Dylanfg123/Signalyzer/README.md

View this project on [CADLAB.io](https://cadlab.io/project/26944). 

# Signalyzer
