Dylanfg123/Signalyzer/Docs/Produce_DanZhi.SMT_Snapshot.Top.2391258A_Y2.SMT02211131024478.png

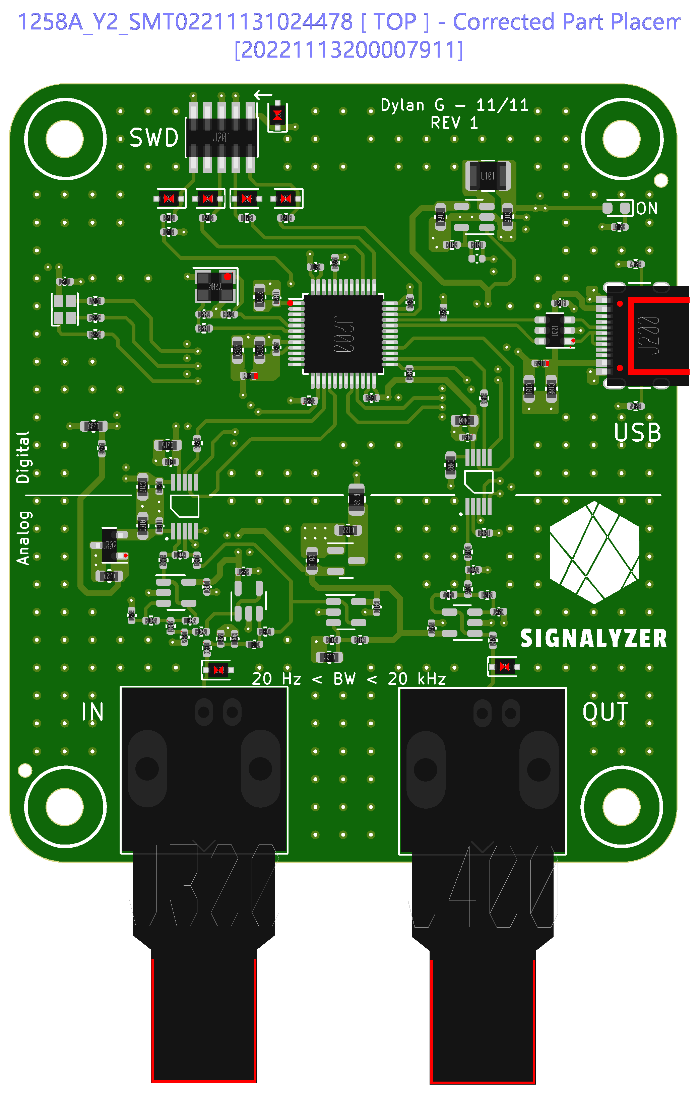
Docs/Produce_DanZhi.SMT_Snapshot.Top.2391258A_Y2.SMT02211131024478.png
