Dylanfg123/Signalyzer/Docs/RoughBom.xlsx

 | Main
 | Part | Description | Qty | Price |  | Link | Alt Link
MCU | STM32F103CBT6 | ARM MCU, Motor Control, STM32 Family STM32F1 Series Microcontrollers, ARM Cortex-M3, 32 bit, 72 MHz | 1 | 8.78 | 11.07 | https://www.newark.com/stmicroelectronics/stm32f103cbt6/microcontroller-mcu-32-bit-cortex/dp/11N8296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 | https://www.arrow.com/en/products/stm32f103cbt6/stmicroelectronics
ADC | ADC141S626CIMM/NOPB | 14 Bit Analog to Digital Converter 1 Input 1 SAR 10-VSSOP | 1 | 11.71 |  | https://www.digikey.com/en/products/detail/ADC141S626CIMM-NOPB/ADC141S626CIMM-NOPBCT-ND/1836097?curr=usd
DAC | DAC7563TDGST | IC DAC 12BIT V-OUT 10VSSOP | 1 | 7.33 |  | https://www.digikey.com/en/products/detail/texas-instruments/DAC7563SDGST/2749385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
SW REG | TLV62569DBVR | Conv DC-DC 2.5V to 5.5V Synchronous Step Down Single-Out 0.6V to 5.5V 2A 5-Pin SOT-23 T/R | 1 | 0.89 |  | https://www.arrow.com/en/products/tlv62569dbvr/texas-instruments?region=nac
LDO | MCP1792T-3302H/CB | IC REG LIN 3.3V 100MA SOT23A-3 | 1 | 0.8 |  | https://www.digikey.com/en/products/detail/microchip-technology/MCP1792T-3302H-CB/10297921
OPAMP | MCP6001UT-I/OT | IC OPAMP GP 1 CIRCUIT SOT23-5 |  | 0.32 |  | https://www.digikey.com/en/products/detail/microchip-technology/MCP6001UT-I-OT/562450
ESD USB | USBLC6-2SC6Y | TVS DIODE 5.25VWM 17VC SOT23-6 | 1 | 1.07 |  | https://www.digikey.com/en/products/detail/stmicroelectronics/USBLC6-2SC6Y/2756523
TVS | PESD3V3L1BA,115 | TVS DIODE 3.3VWM 26VC SOD323 | 7 | 0.5 |  | https://www.digikey.com/en/products/detail/nexperia-usa-inc/PESD3V3L1BA-115/1157438
 | Passives/Connectors
USB C | TYPE-C-31-M-12 | 5A 1 16 Female Type-C SMD USB Connectors ROHS | 1 | 1.13 |  | https://www.lcsc.com/product-detail/USB-Type-C_Korean-Hroparts-Elec-TYPE-C-31-M-12_C165948.html
RGB LED | E6C1206RGBC3UDA | RGB 1206 Light Emitting Diodes (LED) ROHS | 1 | 0.62 |  | https://www.lcsc.com/product-detail/Light-Emitting-Diodes-LED_EKINGLUX-E6C1206RGBC3UDA_C375571.html
VREF | ref3033aidbzt | 3.3-V, 50-ppm/°C, 50-µA in 3-pin SOT-23 package series (bandgap) voltage reference | 1
BNC | 031-5640-1010 | Conn BNC 0Hz to 1GHz 50Ohm Solder RA Thru-Hole RCP Gold | 2 | 2.53 |  | https://www.newark.com/amphenol-rf/031-5640-1010/rf-coaxial-bnc-bulkhead-jack-r/dp/93F7525?CMP=AFC-OP
crystal
 |  |  |  | 35.68 | 31.8
 |  |  |  | Spent so far: | $123.73
