Dylanfg123/Signalyzer/HRO_TYPE-C-31-M-12.step

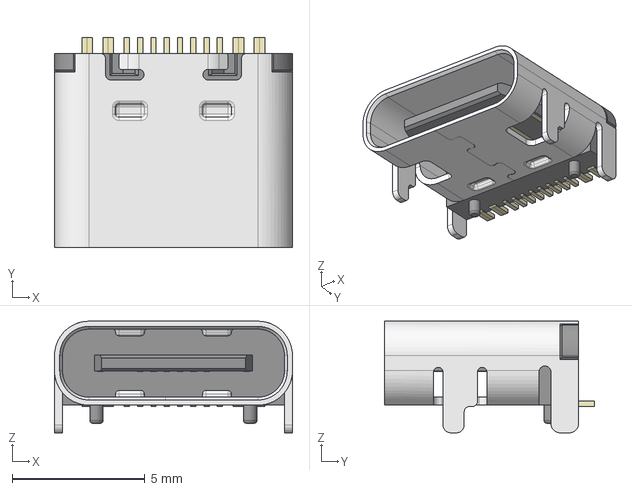
[picture p2: CAD file, 2023-05-13]
HRO_TYPE-C-31-M-12.step
8.95 x 7.90 x 4.20 mm
