Dylanfg123/Signalyzer/DGS0010A.STEP

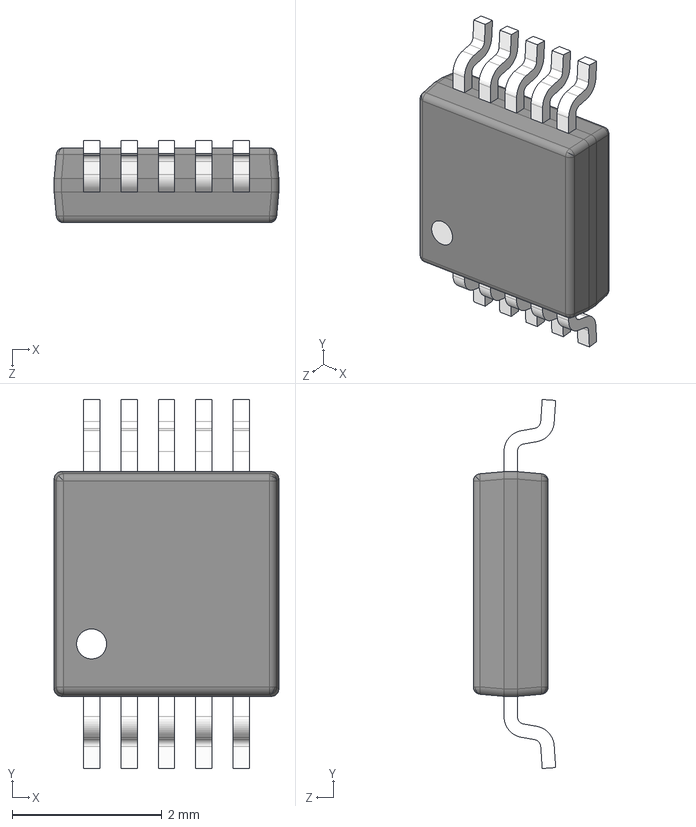
[picture p3: CAD file, 2023-05-13]
DGS0010A.STEP
3.00 x 4.93 x 1.10 mm
DGS0010A_ASM_LEAD-SO#LEAD-SO;LEAD-SO
DGS0010A_ASM_LEAD-SO#LEAD-SO;LEAD-SO_2
DGS0010A_ASM_LEAD-SO#LEAD-SO;LEAD-SO_3
DGS0010A_ASM_LEAD-SO#LEAD-SO;LEAD-SO_4
DGS0010A_ASM_LEAD-SO#LEAD-SO;LEAD-SO_5
DGS0010A_ASM_LEAD-SO#LEAD-SO;LEAD-SO_6
DGS0010A_ASM_LEAD-SO#LEAD-SO;LEAD-SO_7
DGS0010A_ASM_LEAD-SO#LEAD-SO;LEAD-SO_8
DGS0010A_ASM_LEAD-SO#LEAD-SO;LEAD-SO_9
DGS0010A_ASM_LEAD-SO#LEAD-SO;LEAD-SO_10
DGS0010A_ASM_BODY-SO#BODY-SO;BODY-SO
