Dylanfg123/Signalyzer/BNC_B6252HB-NPP3G-50.stp

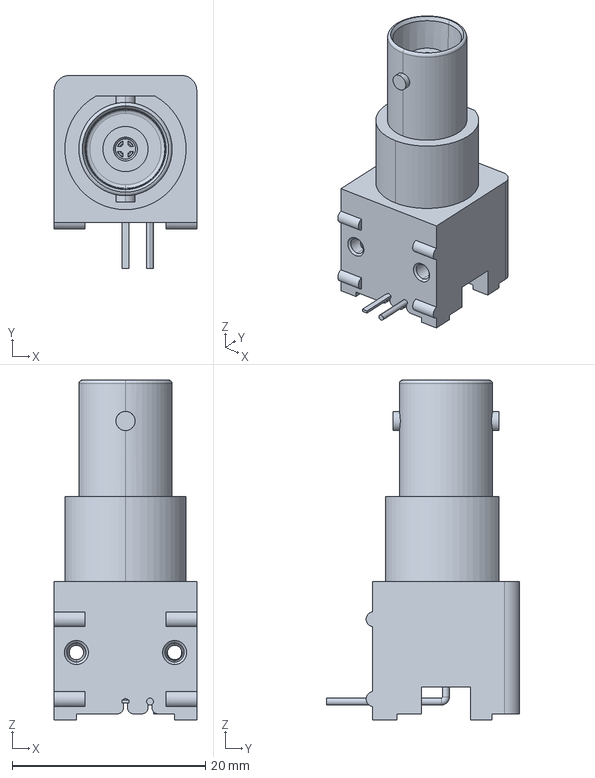
[picture p4: CAD file, 2023-05-13]
BNC_B6252HB-NPP3G-50.stp
14.8 x 20.0 x 35.2 mm
