Dylanfg123/Signalyzer/Signalyzer.kicad_pcb

## KiCad design Signalyzer.kicad_pcb (2023-05-13)

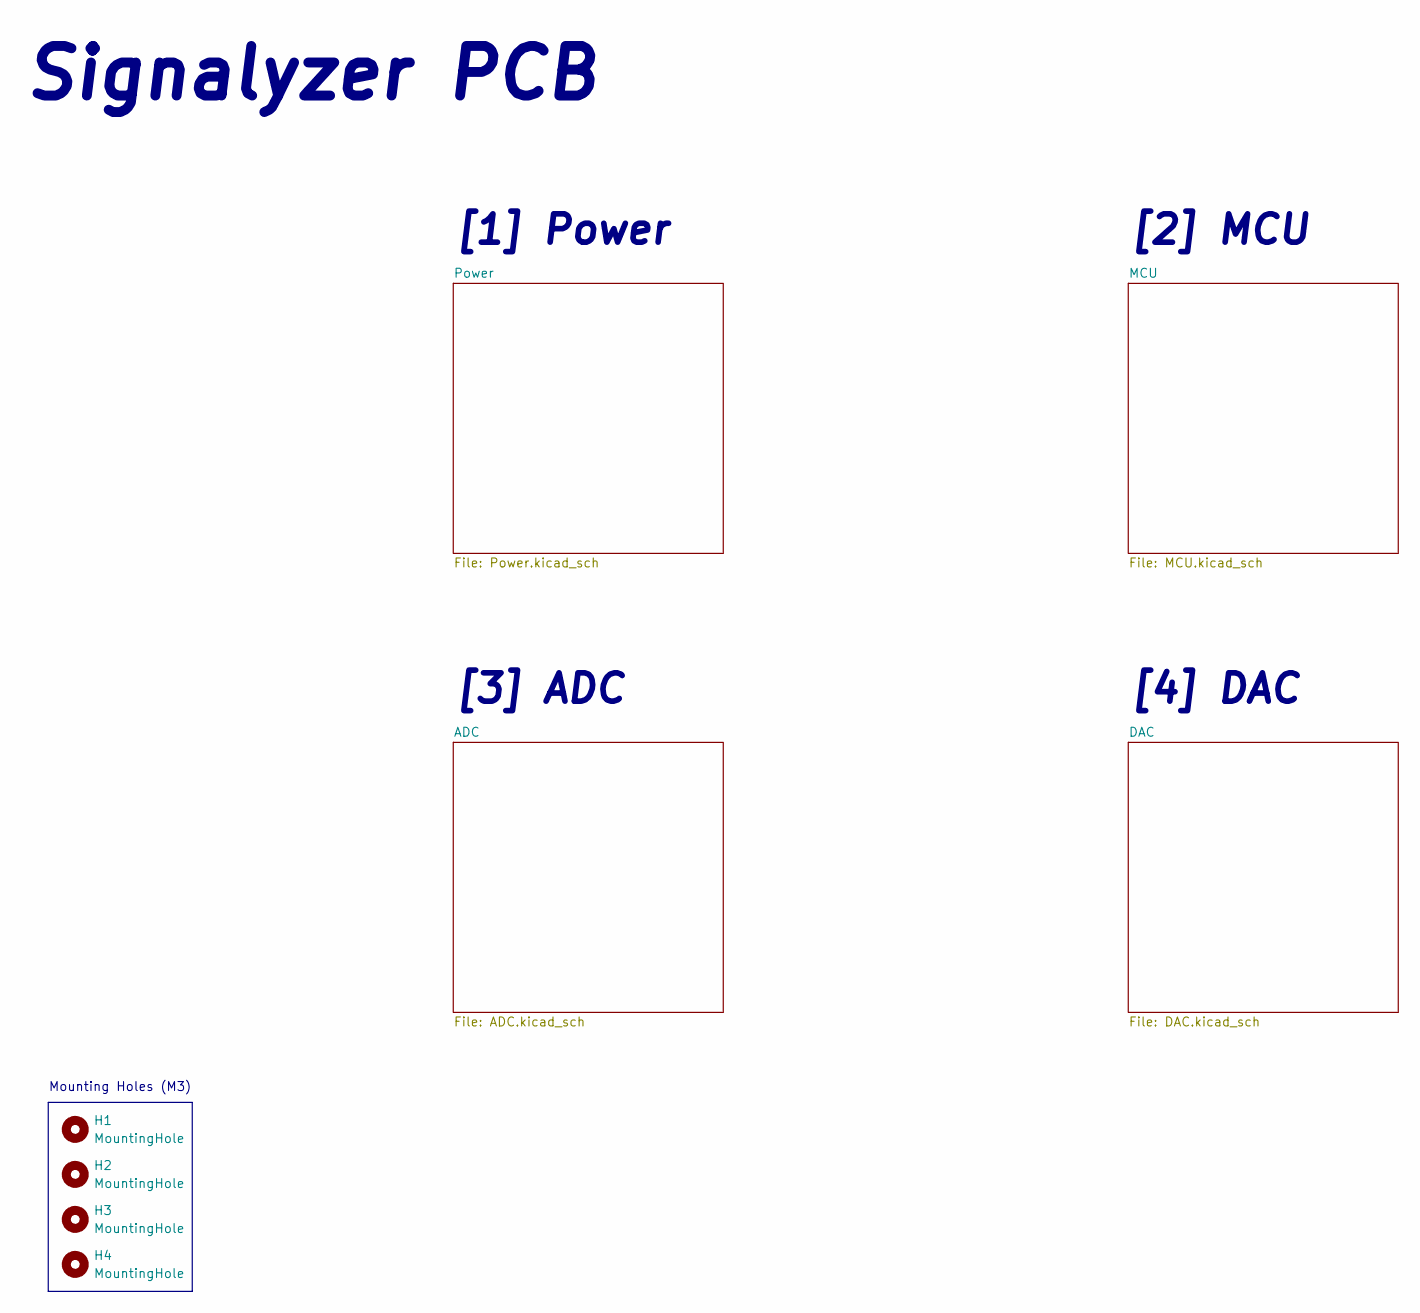
[picture p5: schematic Signalyzer.kicad_sch]

Parts:
H1, H2, H3, H4: MountingHole; MountingHole_3.2mm_M3

Notes on the sheet:
[2] MCU
Mounting Holes (M3)
[4] DAC
Signalyzer PCB
[3] ADC
[1] Power

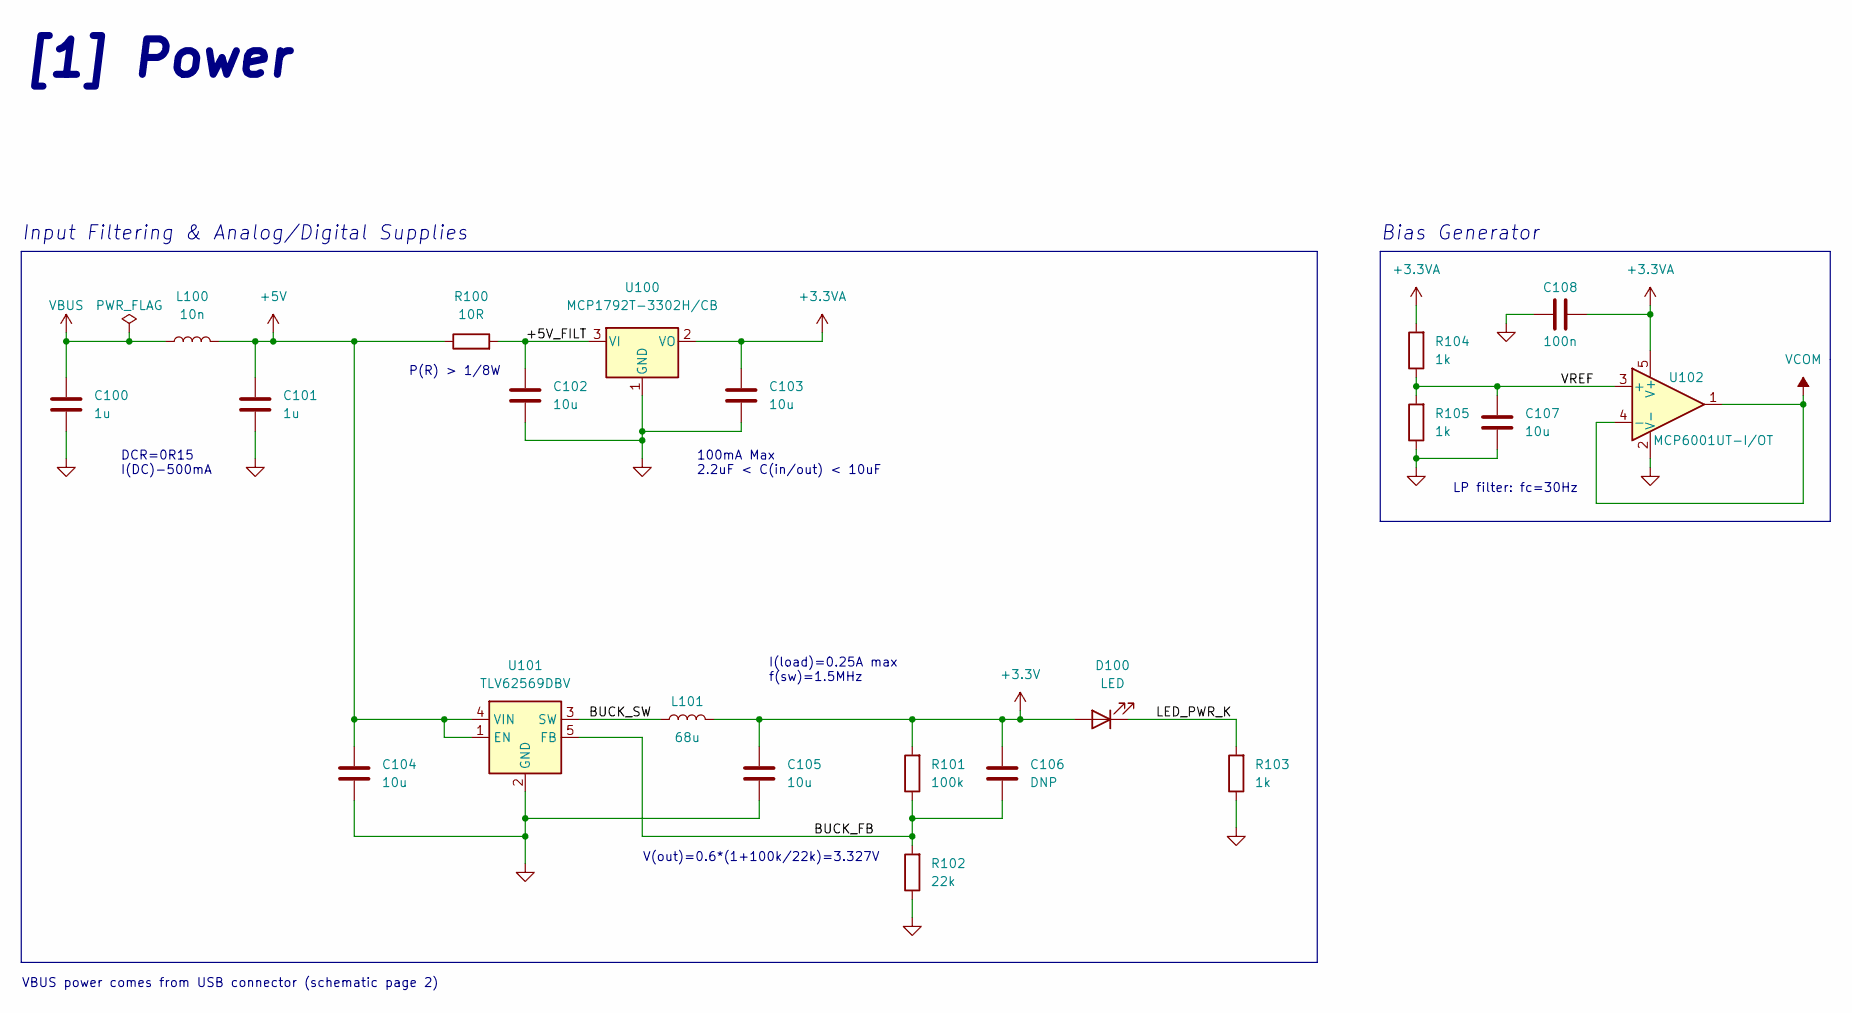
[picture p6: schematic Power.kicad_sch, Signalyzer]

Parts:
C100, C101: 1u; C_0603_1608Metric; Manufacturer Part Number CL10B105KA8VPJC; LCSC Part # C472462
C102, C103, C104, C105, C107: 10u; C_0603_1608Metric; Manufacturer Part Number GRM188R61C106KAALD; LCSC Part # C86275
C106: DNP; C_0402_1005Metric
C108: 100n; C_0402_1005Metric; Manufacturer Part Number CGA2B3X7R1V104KT0Y0F; LCSC Part # C343047
D100: LED; LED_0603_1608Metric; Manufacturer Part Number TJ-S1608SW6TDSLC2R2G-A5; LCSC Part # C601671
L100: 10n; L_0402_1005Metric; Manufacturer Part Number MHQ1005P10NJT000; LCSC Part # C445746
L101: 68u; L_1210_3225Metric; Manufacturer Part Number BCL322520RT-680M-D; LCSC Part # C3221319
R100: 10R; R_0805_2012Metric; Manufacturer Part Number RTAN0805BKE10R0; LCSC Part # C346749
R101: 100k; R_0402_1005Metric; Manufacturer Part Number ERA2AEB104X; LCSC Part # C445619
R102: 22k; R_0402_1005Metric; Manufacturer Part Number PTFR0402B22K0N9; LCSC Part # C2693021
R103, R104, R105: 1k; R_0402_1005Metric; Manufacturer Part Number ERA2AEB102X; LCSC Part # C445596
U100: MCP1792T-3302H/CB; SOT-23; Manufacturer Part Number MCP1792T-3302H/CB
U101: TLV62569DBV; SOT-23-5; Manufacturer Part Number TLV62569DBVR
U102: MCP6001UT-I/OT; SOT-23-5; Manufacturer Part Number MCP6001UT-I/OT

Connections:
+3.3VA: C103.1, C108.2, R104.2, U100.2 (VO), U102.5 (V+); also elsewhere on the board
+3V3: C105.1, C106.1, D100.2 (A), L101.2, R101.2; also elsewhere on the board
+5V: C101.1, C104.1, L100.2, R100.1, U101.1 (EN), U101.4 (VIN); also elsewhere on the board
/Power/+5V_FILT: C102.1, R100.2, U100.3 (VI)
/Power/BUCK_FB: C106.2, R101.1, R102.2, U101.5 (FB)
/Power/BUCK_SW: L101.1, U101.3 (SW)
/Power/LED_PWR_K: D100.1 (K), R103.2
/Power/VREF: C107.1, R104.1, R105.2, U102.3 (+)
GND: C100.2, C101.2, C102.2, C103.2, C104.2, C105.2, C107.2, C108.1, R102.1, R103.1, R105.1, U100.1 (GND), U101.2 (GND), U102.2 (V-); also elsewhere on the board
VBUS: C100.1, L100.1; also elsewhere on the board
VCOM: U102.1, U102.4 (-); also elsewhere on the board

Notes on the sheet:
100mA Max 2.2uF < C(in/out) < 10uF
VBUS power comes from USB connector (schematic page 2)
P(R) > 1/8W
V(out)=0.6*(1+100k/22k)=3.327V
LP filter: fc=30Hz
I(load)=0.25A max f(sw)=1.5MHz
DCR=0R15 I(DC)-500mA
Input Filtering & Analog/Digital Supplies
Bias Generator
[1] Power

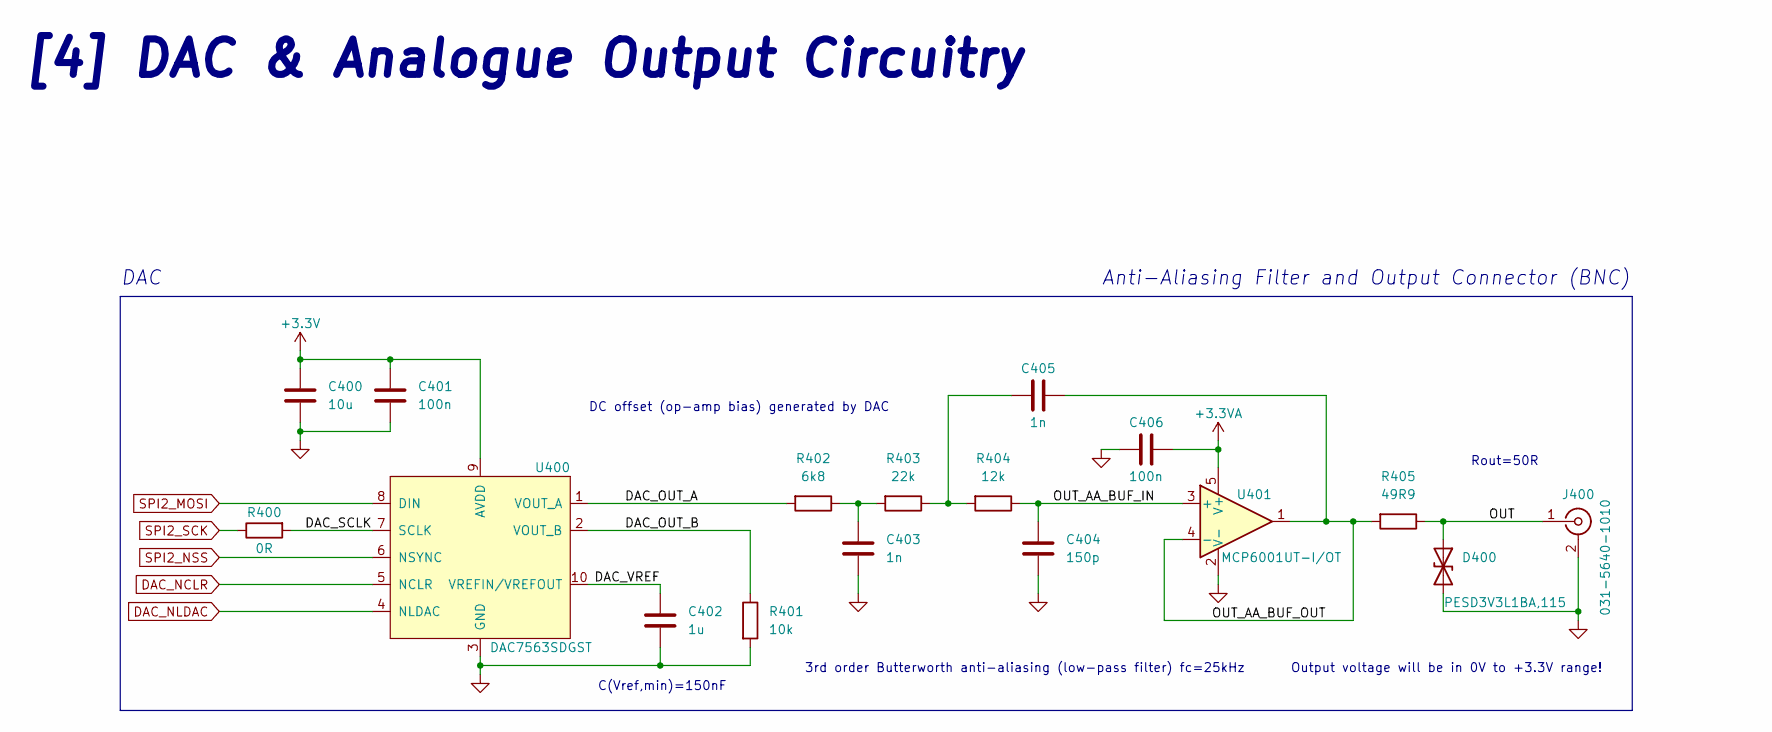
[picture p7: schematic DAC.kicad_sch, Signalyzer]

Parts:
C400: 10u; C_0603_1608Metric; Manufacturer Part Number GRM188R61C106KAALD; LCSC Part # C86275
C401, C406: 100n; C_0402_1005Metric; Manufacturer Part Number CGA2B3X7R1V104KT0Y0F; LCSC Part # C343047
C402: 1u; C_0603_1608Metric; Manufacturer Part Number CL10B105KA8VPJC; LCSC Part # C472462
C403, C405: 1n; C_0402_1005Metric; Manufacturer Part Number GRM1555C2A102GE01D; LCSC Part # C3010445
C404: 150p; C_0402_1005Metric; Manufacturer Part Number CC0402KRX7R9BB151; LCSC Part # C113789
D400: PESD3V3L1BA,115; D_SOD-323; Manufacturer Part Number PESD3V3L1BA,115; LCSC Part # C51450
J400: 031-5640-1010; BNC_Amphenol_B6252HB-NPP3G-50_Horizontal; Manufacturer Part Number 031-5640-1010
R400: 0R; R_0402_1005Metric; Manufacturer Part Number HCJ0402ZT0R00; LCSC Part # C346504
R401: 10k; R_0402_1005Metric; Manufacturer Part Number ERJPA2F1002X; LCSC Part # C427247
R402: 6k8; R_0402_1005Metric; Manufacturer Part Number ERA2VEB6801X; LCSC Part # C543679
R403: 22k; R_0402_1005Metric; Manufacturer Part Number PTFR0402B22K0N9; LCSC Part # C2693021
R404: 12k; R_0402_1005Metric; Manufacturer Part Number ERA2AEB123X; LCSC Part # C215763
R405: 49R9; R_0402_1005Metric; Manufacturer Part Number PTFR0402B49K9N9; LCSC Part # C2692755
U400: DAC7563SDGST; VSSOP-10; Manufacturer Part Number DAC7563SDGST
U401: MCP6001UT-I/OT; SOT-23-5; Manufacturer Part Number MCP6001UT-I/OT

Connections:
+3.3VA: C406.1, U401.5 (V+); also elsewhere on the board
+3V3: C400.1, C401.1, U400.9 (AVDD); also elsewhere on the board
/DAC/DAC_OUT_A: R402.2, U400.1 (VOUT_A)
/DAC/DAC_OUT_B: R401.1, U400.2 (VOUT_B)
/DAC/DAC_SCLK: R400.2, U400.7 (SCLK)
/DAC/DAC_VREF: C402.1, U400.10 (VREFIN/VREFOUT)
/DAC/OUT: D400.1 (A1), J400.1 (In), R405.1
/DAC/OUT_AA_BUF_IN: C404.1, R404.1, U401.3 (+)
/DAC/OUT_AA_BUF_OUT: C405.2, R405.2, U401.1, U401.4 (-)
DAC_NCLR: U400.5 (NCLR); also elsewhere on the board
DAC_NLDAC: U400.4 (NLDAC); also elsewhere on the board
GND: C400.2, C401.2, C402.2, C403.2, C404.2, C406.2, D400.2 (A2), J400.2 (Ext), R401.2, U400.3 (GND), U401.2 (V-); also elsewhere on the board
unnamed: C403.1, R402.1, R403.2
unnamed: C405.1, R403.1, R404.2
SPI2_MOSI: U400.8 (DIN); also elsewhere on the board
SPI2_NSS: U400.6 (NSYNC); also elsewhere on the board
SPI2_SCK: R400.1; also elsewhere on the board

Notes on the sheet:
Rout=50R
3rd order Butterworth anti-aliasing (low-pass filter) fc=25kHz
DAC
DC offset (op-amp bias) generated by DAC
Anti-Aliasing Filter and Output Connector (BNC)
C(Vref,min)=150nF
[4] DAC & Analogue Output Circuitry
Output voltage will be in 0V to +3.3V range!

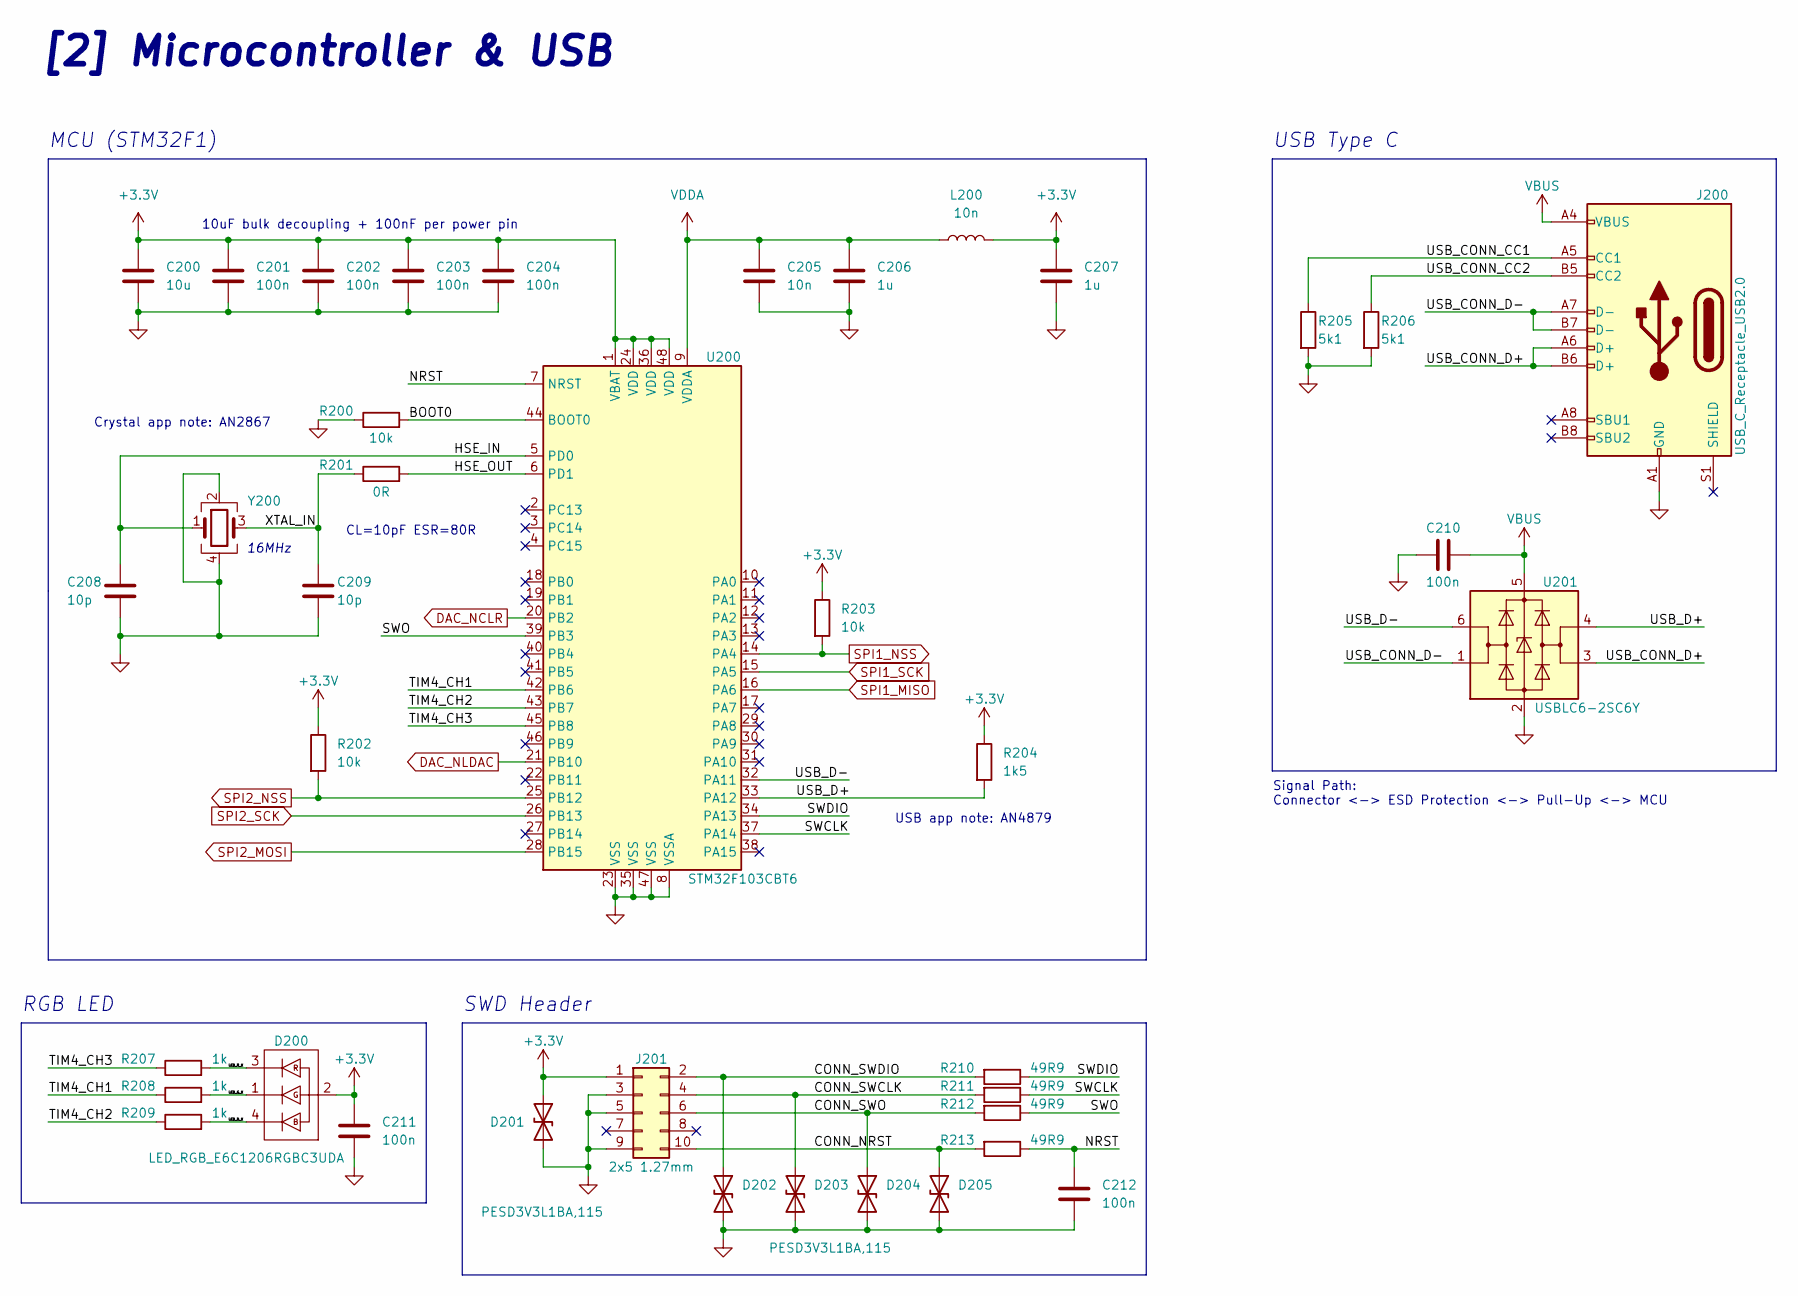
[picture p8: schematic MCU.kicad_sch, Signalyzer]

Parts:
C200: 10u; C_0603_1608Metric; Manufacturer Part Number GRM188R61C106KAALD; LCSC Part # C86275
C201, C202, C203, C204, C210, C211, C212: 100n; C_0402_1005Metric; Manufacturer Part Number CGA2B3X7R1V104KT0Y0F; LCSC Part # C343047
C205: 10n; C_0402_1005Metric; Manufacturer Part Number C0402C103K4RECAUTO; LCSC Part # C696351
C206, C207: 1u; C_0603_1608Metric; Manufacturer Part Number CL10B105KA8VPJC; LCSC Part # C472462
C208, C209: 10p; C_0402_1005Metric; Manufacturer Part Number 04023J100FBSTR; LCSC Part # C2154389
D200: LED_RGB_E6C1206RGBC3UDA; LED_Cree-PLCC4_2x2mm_CW; Manufacturer Part Number E6C1206RGBC3UDA; LCSC Part # C375571
D201, D202, D203, D204, D205: PESD3V3L1BA,115; D_SOD-323; Manufacturer Part Number PESD3V3L1BA,115; LCSC Part # C51450
J200: USB_C_Receptacle_USB2.0; USB_C_Receptacle_HRO_TYPE-C-31-M-12; Manufacturer Part Number TYPE-C-31-M-12; LCSC Part # C165948
J201: 2x5 1.27mm; PinHeader_2x05_P1.27mm_Vertical_SMD; Manufacturer Part Number DZ127S-22-10-55; LCSC Part # C5160761
L200: 10n; L_0402_1005Metric; Manufacturer Part Number MHQ1005P10NJT000; LCSC Part # C445746
R200, R202, R203: 10k; R_0402_1005Metric; Manufacturer Part Number ERJPA2F1002X; LCSC Part # C427247
R201: 0R; R_0402_1005Metric; Manufacturer Part Number HCJ0402ZT0R00; LCSC Part # C346504
R204: 1k5; R_0402_1005Metric; Manufacturer Part Number ERA2AEB152X; LCSC Part # C445600
R205, R206: 5k1; R_0402_1005Metric; Manufacturer Part Number ERA2AEB512X; LCSC Part # C490833
R207, R208, R209: 1k; R_0402_1005Metric; Manufacturer Part Number ERA2AEB102X; LCSC Part # C445596
R210, R211, R212, R213: 49R9; R_0402_1005Metric; Manufacturer Part Number PTFR0402B49K9N9; LCSC Part # C2692755
U200: STM32F103CBT6; LQFP-48_7x7mm_P0.5mm; Manufacturer Part Number STM32F103CBT6
U201: USBLC6-2SC6Y; SOT-23-6; Manufacturer Part Number USBLC6-2SC6Y
Y200: Crystal_GND24; Crystal_SMD_3225-4Pin_3.2x2.5mm; Manufacturer Part Number WTL3M01610; LCSC Part # C2857621

Connections:
+3V3: C200.1, C201.1, C202.1, C203.1, C204.1, C207.1, C211.1, D200.2, D201.1 (A1), J201.1, L200.2, R202.1, R203.1, R204.1, U200.1 (VBAT), U200.24 (VDD), U200.36 (VDD), U200.48 (VDD); also elsewhere on the board
/MCU/BOOT0: R200.2, U200.44 (BOOT0)
/MCU/CONN_NRST: D205.1 (A1), J201.10, R213.2
/MCU/CONN_SWCLK: D203.1 (A1), J201.4, R211.2
/MCU/CONN_SWDIO: D202.1 (A1), J201.2, R210.2
/MCU/CONN_SWO: D204.1 (A1), J201.6, R212.2
/MCU/HSE_IN: C208.1, U200.5 (PD0), Y200.1
/MCU/HSE_OUT: R201.2, U200.6 (PD1)
/MCU/LED_B_K: D200.4, R209.2
/MCU/LED_G_K: D200.1, R208.2
/MCU/LED_R_K: D200.3, R207.2
/MCU/NRST: C212.1, R213.1, U200.7 (NRST)
/MCU/SWCLK: R211.1, U200.37 (PA14)
/MCU/SWDIO: R210.1, U200.34 (PA13)
/MCU/SWO: R212.1, U200.39 (PB3)
/MCU/TIM4_CH1: R208.1, U200.42 (PB6)
/MCU/TIM4_CH2: R209.1, U200.43 (PB7)
/MCU/TIM4_CH3: R207.1, U200.45 (PB8)
/MCU/USB_CONN_CC1: J200.A5 (CC1), R205.1
/MCU/USB_CONN_CC2: J200.B5 (CC2), R206.1
/MCU/USB_CONN_D+: J200.A6 (D+), J200.B6 (D+), U201.3 (I/O2)
/MCU/USB_CONN_D-: J200.A7 (D-), J200.B7 (D-), U201.1 (I/O1)
/MCU/USB_D+: R204.2, U200.33 (PA12), U201.4 (I/O2)
/MCU/USB_D-: U200.32 (PA11), U201.6 (I/O1)
/MCU/XTAL_IN: C209.1, R201.1, Y200.3
DAC_NCLR: U200.20 (PB2); also elsewhere on the board
DAC_NLDAC: U200.21 (PB10); also elsewhere on the board
GND: C200.2, C201.2, C202.2, C203.2, C204.2, C205.2, C206.2, C207.2, C208.2, C209.2, C210.2, C211.2, C212.2, D201.2 (A2), D202.2 (A2), D203.2 (A2), D204.2 (A2), D205.2 (A2), J200.A1 (GND), J200.A12 (GND), J200.B1 (GND), J200.B12 (GND), J201.3, J201.5, J201.9, R200.1, R205.2, R206.2, U200.8 (VSSA), U200.23 (VSS), U200.35 (VSS), U200.47 (VSS), U201.2 (GND), Y200.2, Y200.4; also elsewhere on the board
SPI1_MISO: U200.16 (PA6); also elsewhere on the board
SPI1_NSS: R203.2, U200.14 (PA4); also elsewhere on the board
SPI1_SCK: U200.15 (PA5); also elsewhere on the board
SPI2_MOSI: U200.28 (PB15); also elsewhere on the board
SPI2_NSS: R202.2, U200.25 (PB12); also elsewhere on the board
SPI2_SCK: U200.26 (PB13); also elsewhere on the board
VBUS: C210.1, J200.A4 (VBUS), J200.A9 (VBUS), J200.B4 (VBUS), J200.B9 (VBUS), U201.5 (VBUS); also elsewhere on the board
VDDA: C205.1, C206.1, L200.1, U200.9 (VDDA)

Notes on the sheet:
10uF bulk decoupling + 100nF per power pin
SWD Header
CL=10pF ESR=80R
16MHz
USB app note: AN4879
Crystal app note: AN2867
[2] Microcontroller & USB
MCU (STM32F1)
USB Type C
RGB LED
Signal Path: Connector <-> ESD Protection <-> Pull-Up <-> MCU

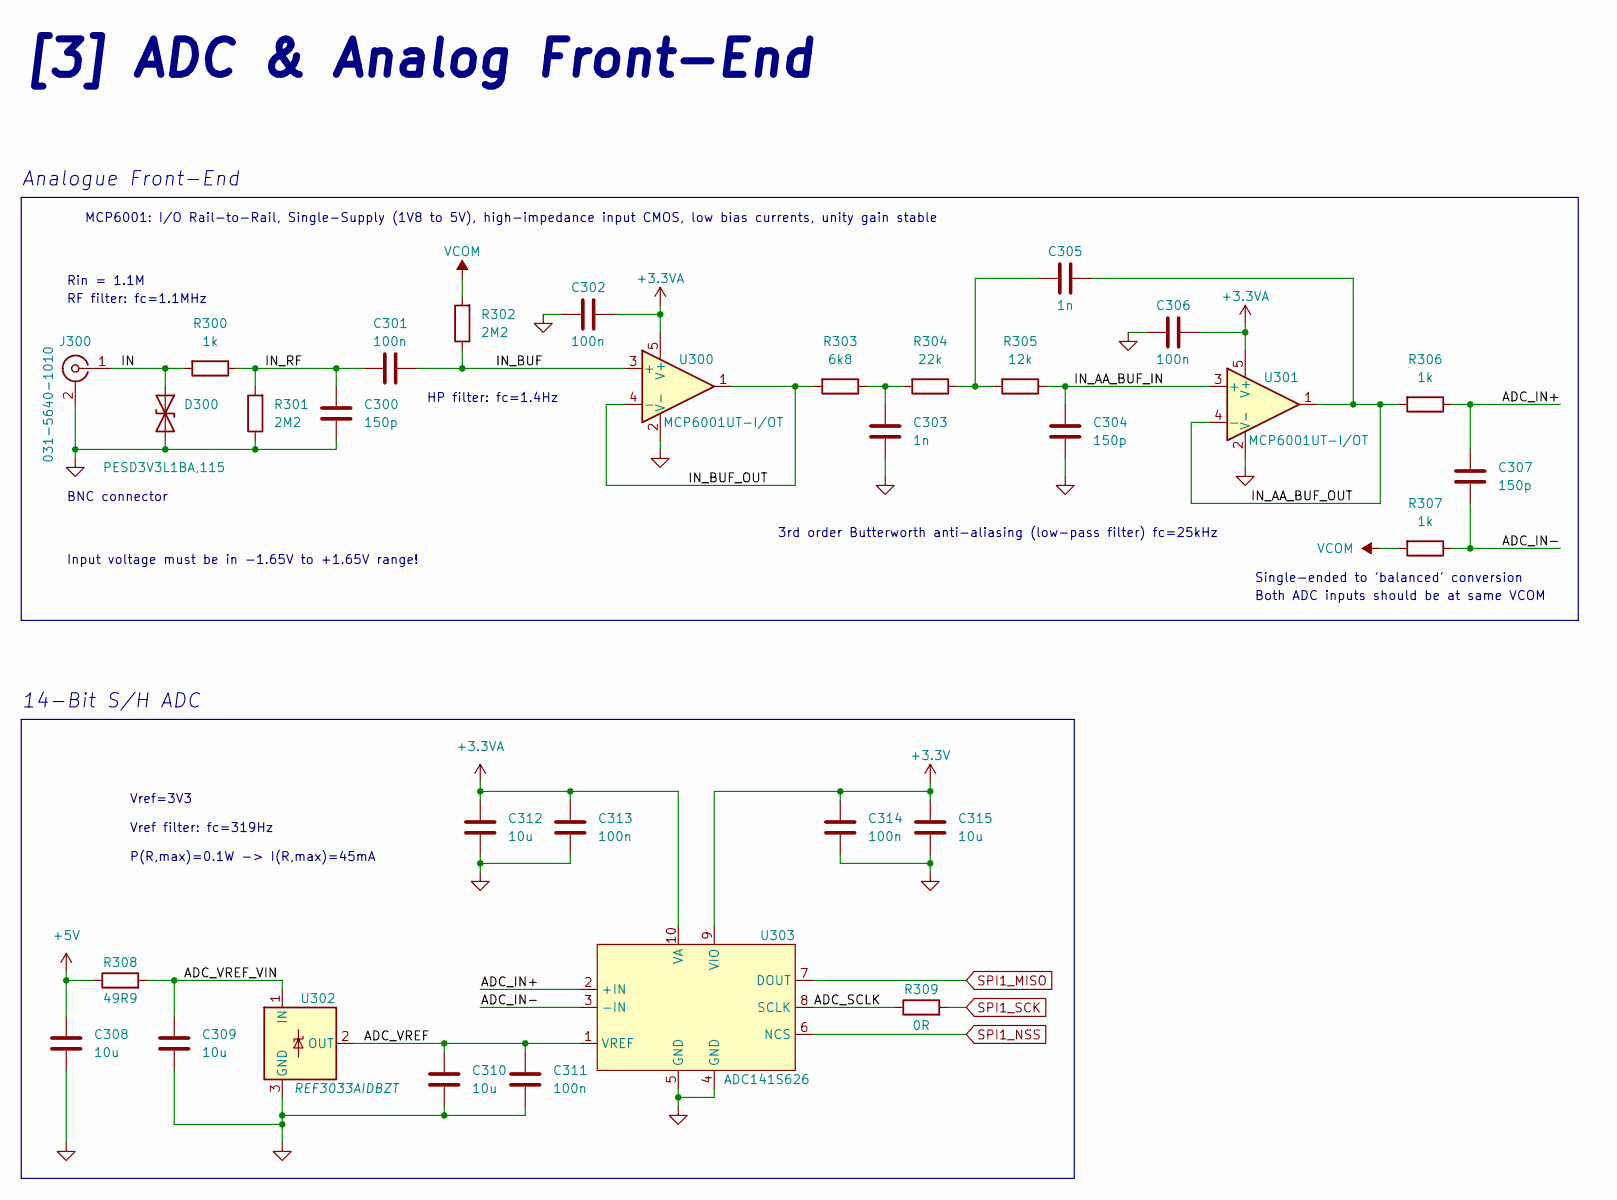
[picture p9: schematic ADC.kicad_sch, Signalyzer]

Parts:
C300, C304, C307: 150p; C_0402_1005Metric; Manufacturer Part Number CC0402KRX7R9BB151; LCSC Part # C113789
C301, C302, C306, C311, C313, C314: 100n; C_0402_1005Metric; Manufacturer Part Number CGA2B3X7R1V104KT0Y0F; LCSC Part # C343047
C303, C305: 1n; C_0402_1005Metric; Manufacturer Part Number GRM1555C2A102GE01D; LCSC Part # C3010445
C308, C309, C310, C312, C315: 10u; C_0603_1608Metric; Manufacturer Part Number GRM188R61C106KAALD; LCSC Part # C86275
D300: PESD3V3L1BA,115; D_SOD-323; Manufacturer Part Number PESD3V3L1BA,115; LCSC Part # C51450
J300: 031-5640-1010; BNC_Amphenol_B6252HB-NPP3G-50_Horizontal; Manufacturer Part Number 031-5640-1010
R300, R306, R307: 1k; R_0402_1005Metric; Manufacturer Part Number ERA2AEB102X; LCSC Part # C445596
R301, R302: 2M2; R_0402_1005Metric; Manufacturer Part Number CRCW04022M20FKED; LCSC Part # C482136
R303: 6k8; R_0402_1005Metric; Manufacturer Part Number ERA2VEB6801X; LCSC Part # C543679
R304: 22k; R_0402_1005Metric; Manufacturer Part Number PTFR0402B22K0N9; LCSC Part # C2693021
R305: 12k; R_0402_1005Metric; Manufacturer Part Number ERA2AEB123X; LCSC Part # C215763
R308: 49R9; R_0402_1005Metric; Manufacturer Part Number PTFR0402B49K9N9; LCSC Part # C2692755
R309: 0R; R_0402_1005Metric; Manufacturer Part Number HCJ0402ZT0R00; LCSC Part # C346504
U300, U301: MCP6001UT-I/OT; SOT-23-5; Manufacturer Part Number MCP6001UT-I/OT
U302: REF3033AIDBZT; SOT-23; Manufacturer Part Number REF3033AIDBZT
U303: ADC141S626; VSSOP-10; Manufacturer Part Number ADC141S626CIMM/NOPB

Connections:
+3.3VA: C302.1, C306.1, C312.1, C313.1, U300.5 (V+), U301.5 (V+), U303.10 (VA); also elsewhere on the board
+3V3: C314.1, C315.1, U303.9 (VIO); also elsewhere on the board
+5V: C308.1, R308.1; also elsewhere on the board
/ADC/ADC_IN+: C307.1, R306.1, U303.2 (+IN)
/ADC/ADC_IN-: C307.2, R307.1, U303.3 (-IN)
/ADC/ADC_SCLK: R309.1, U303.8 (SCLK)
/ADC/ADC_VREF: C310.1, C311.1, U302.2 (OUT), U303.1 (VREF)
/ADC/ADC_VREF_VIN: C309.1, R308.2, U302.1 (IN)
/ADC/IN: D300.1 (A1), J300.1 (In), R300.2
/ADC/IN_AA_BUF_IN: C304.1, R305.1, U301.3 (+)
/ADC/IN_AA_BUF_OUT: C305.2, R306.2, U301.1, U301.4 (-)
/ADC/IN_BUF: C301.1, R302.1, U300.3 (+)
/ADC/IN_BUF_OUT: R303.2, U300.1, U300.4 (-)
/ADC/IN_RF: C300.1, C301.2, R300.1, R301.2
GND: C300.2, C302.2, C303.2, C304.2, C306.2, C308.2, C309.2, C310.2, C311.2, C312.2, C313.2, C314.2, C315.2, D300.2 (A2), J300.2 (Ext), R301.1, U300.2 (V-), U301.2 (V-), U302.3 (GND), U303.4 (GND), U303.5 (GND); also elsewhere on the board
unnamed: C303.1, R303.1, R304.2
unnamed: C305.1, R304.1, R305.2
SPI1_MISO: U303.7 (DOUT); also elsewhere on the board
SPI1_NSS: U303.6 (NCS); also elsewhere on the board
SPI1_SCK: R309.2; also elsewhere on the board
VCOM: R302.2, R307.2; also elsewhere on the board

Notes on the sheet:
HP filter: fc=1.4Hz
Analogue Front-End
14-Bit S/H ADC
Rin = 1.1M
MCP6001: I/O Rail-to-Rail, Single-Supply (1V8 to 5V), high-impedance input CMOS, low bias currents, unity gain stable
Input voltage must be in -1.65V to +1.65V range!
3rd order Butterworth anti-aliasing (low-pass filter) fc=25kHz
BNC connector
Vref=3V3 Vref filter: fc=319Hz P(R,max)=0.1W -> I(R,max)=45mA
Both ADC inputs should be at same VCOM
RF filter: fc=1.1MHz
Single-ended to 'balanced' conversion
[3] ADC & Analog Front-End

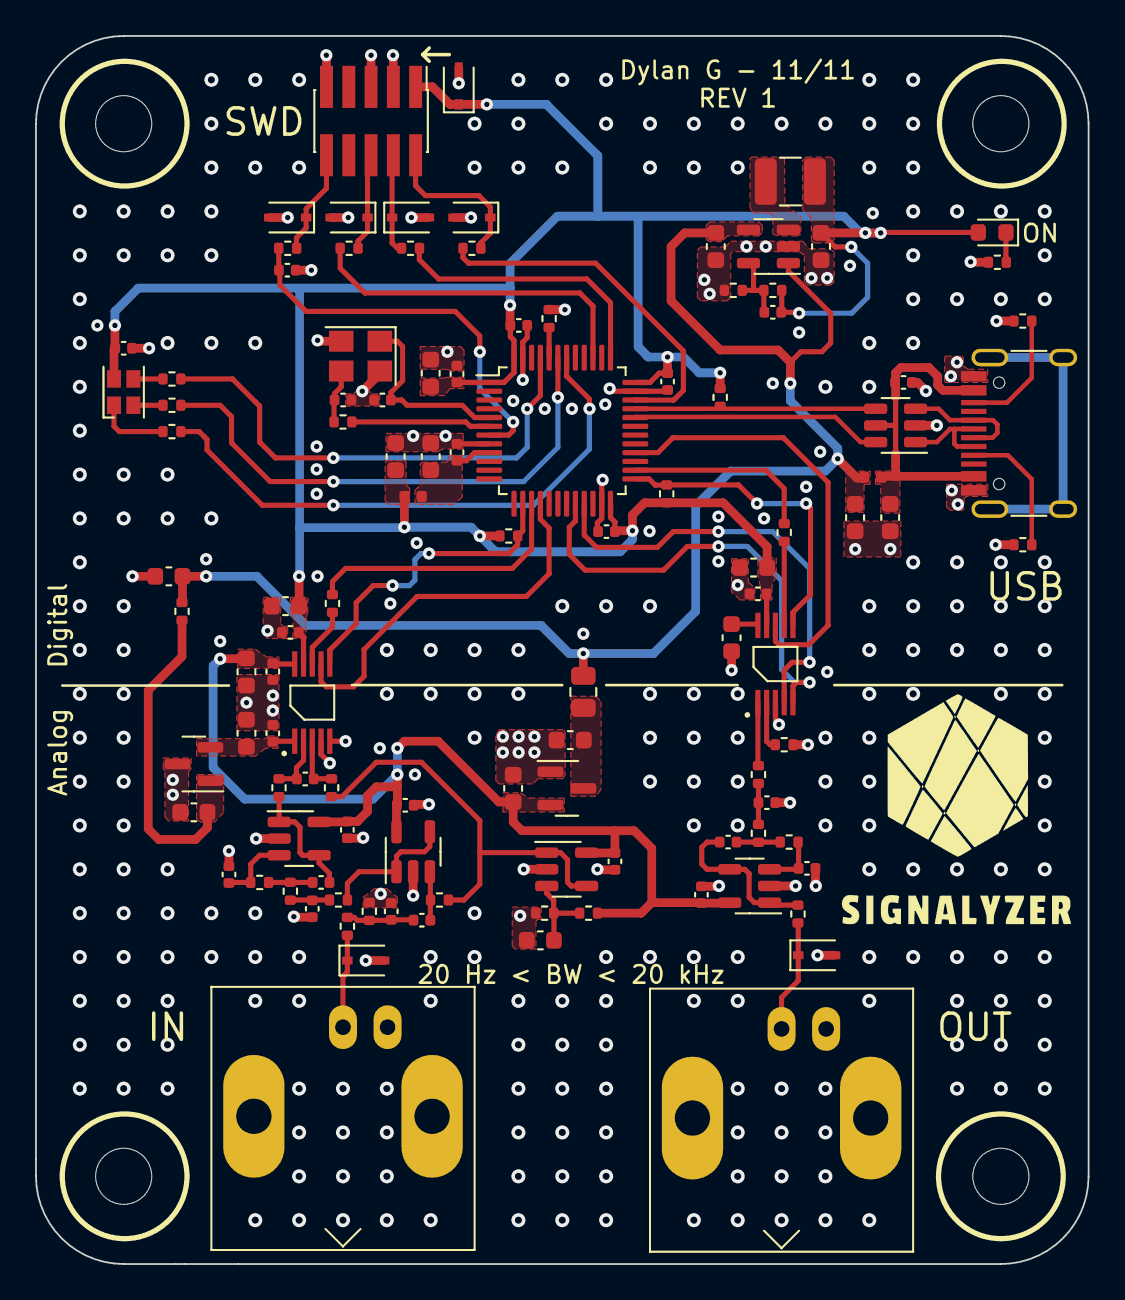
[picture p10: board Signalyzer.kicad_pcb from above]

Board: 4 copper layers, 60.0 x 70.0 mm, 113 parts (0 on the bottom side), 66 nets.
